pajorge/repository/gleitschiene-links/referencia/foto_anotada.jpg

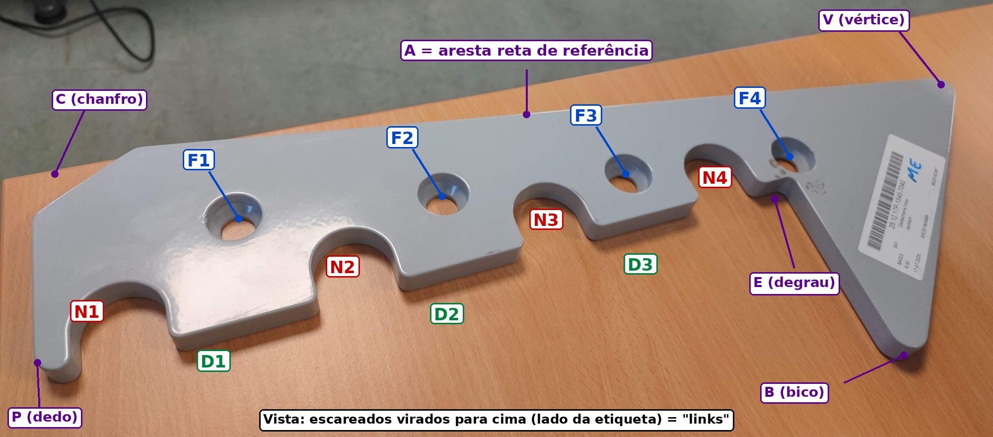
gleitschiene-links/referencia/foto_anotada.jpg
