pajorge/repository/gleitschiene-links/medicao/esquema_medicao.pdf

F1 | F2 | F3 | F4

N1

N2

N3

N4

## aresta A (reta)

F1 no 100

COMO
1. Fita presa ao longo da aresta A com o centro do F1 no 100 (como antes).
2. ANTES: encosta o esquadro à aresta A e escreve a leitura da régua do esquadro na própria aresta A → RA = ____
3. Para cada ponto P: base do esquadro na aresta A; desliza até a régua do esquadro passar EXATAMENTE no ponto. Escreve 2 leituras: X na fita e R na régua do esquadro. (Y = distância entre R e RA — faço eu as contas.)
4. Cada parede tem 2 pontos: 'em cima' (logo abaixo do arco) e 'em baixo' (4 mm acima do canto do dente).
A régua do esquadro só toca a parede no ponto — é normal, é assim que se mede o ângulo.
5. Quadrados laranja (X1–X5): só a leitura da fita.

Parede inclinada ou arredondamento?

folga SÓ numa ponta
= parede inclinada

folga nas DUAS pontas
= arredondamentos (normal)
0 | 50 | 100 | 150 | 200 | 250 | 300 | 350 | 400 | 450 | 500 | 550

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
X2 X3

X4

X5

# 1) PONTOS: X na fita + Y na régua do esquadro (2 pontos por parede)

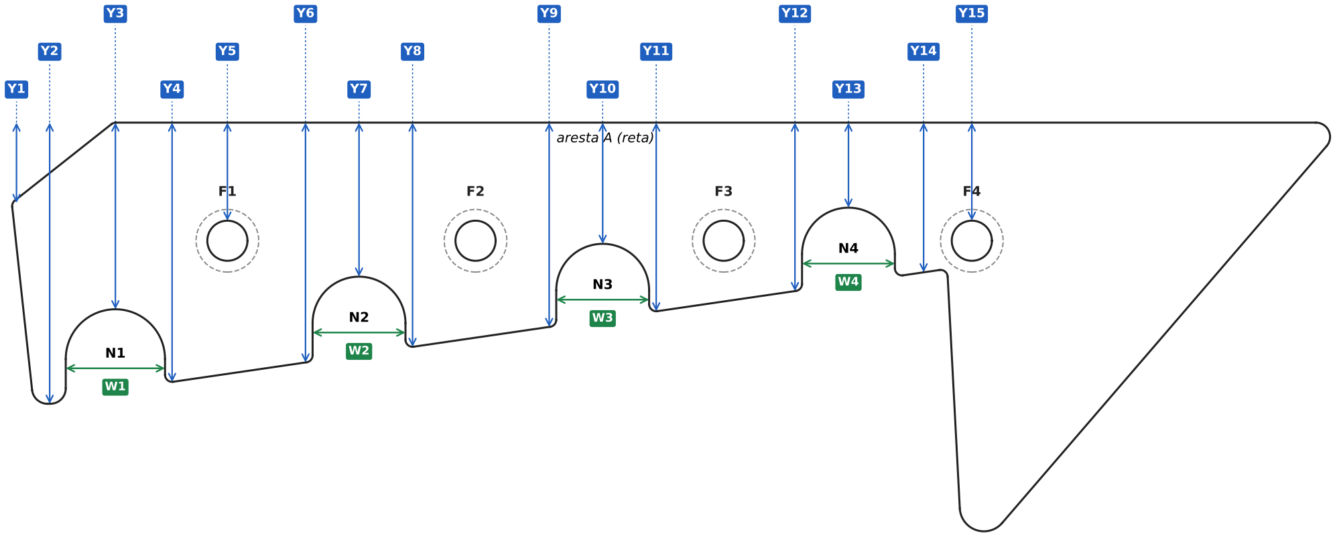
[picture p2: figure]
aresta A (reta)

COMO
- Y (azul): um bico do paquímetro na aresta A e o outro no ponto, sempre a 90° da aresta A.

Dentes: a ~3 mm do canto. Rasgos (Y3, Y7, Y10, Y13): o bico entra e encosta no fundo do arco. Furos (Y5, Y15): da aresta A ao bordo mais próximo, do lado SEM caixa.
- W (verde): largura de cada rasgo com os bicos de DENTRO, perto da boca, a 90° das paredes.
- Escreve só o que leres (com tinta). A correção da tinta faço eu.

# 2) ALTURAS e LARGURAS com o paquímetro

# 3) TABELA — pontos (fita + esquadro)

Esperado = modelo atual, com as paredes ainda a 90°. Nas paredes, diferenças de alguns mm no X são o que queremos medir.

# | O quê | X esp. | Y esp. | X lido (fita) | R lido (esquadro)

| RA = leitura da régua do esquadro na aresta A
| PONTOS NAS PAREDES
P1 | topo esquerda, em cima (3 mm abaixo do chanfro) | 9 | 37
P2 | topo esquerda, em baixo (10 mm acima do fundo do dedo) | 17 | 109
P3 | N1 parede esquerda, em cima (logo abaixo do arco) | 32 | 102
P4 | N1 parede esquerda, em baixo (4 mm acima do canto) | 32 | 112
P5 | N1 parede direita, em cima (logo abaixo do arco) | 74 | 102
P6 | N1 parede direita, em baixo (4 mm acima do canto) | 74 | 106
P7 | N2 parede esquerda, em cima (logo abaixo do arco) | 136 | 87
P8 | N2 parede esquerda, em baixo (4 mm acima do canto) | 136 | 97
P9 | N2 parede direita, em cima (logo abaixo do arco) | 175 | 87
P10 | N2 parede direita, em baixo (4 mm acima do canto) | 175 | 91
P11 | N3 parede esquerda, em cima (logo abaixo do arco) | 239 | 73
P12 | N3 parede esquerda, em baixo (4 mm acima do canto) | 239 | 82
P13 | N3 parede direita, em cima (logo abaixo do arco) | 278 | 73
P14 | N3 parede direita, em baixo (4 mm acima do canto) | 278 | 76
P15 | N4 parede esquerda, em cima (logo abaixo do arco) | 343 | 58
P16 | N4 parede esquerda, em baixo (4 mm acima do canto) | 343 | 67
P17 | N4 parede direita, em cima (logo abaixo do arco) | 382 | 58
P18 | N4 parede direita, em baixo (4 mm acima do canto) | 382 | 61
P19 | degrau E, em cima (5 mm abaixo do patamar) | 405 | 67
P20 | degrau E, em baixo (logo acima do arredondamento do bico) | 410 | 160
| SÓ FITA
X1 | fim do chanfro na aresta A | 52
X2 | F1 bordo esquerdo | 92
X3 | F1 bordo direito | 108
X4 | bico B (ponto mais baixo) | 420
X5 | fim da peça (vértice V) | 567

# 4) TABELA — paquímetro, raios e outros

Esperado = modelo atual, já com a tinta (Y +1 mm; larguras −1 mm). Diferença > 2 mm → mede de novo.

# | O quê | Esperado | Lido

| ALTURAS (paquímetro, com tinta)
Y1 | chanfro: quanto desce na topo | 35
Y2 | altura total no dedo P | 120
Y3 | N1: da aresta A ao fundo do rasgo | 80
Y4 | D1 canto esquerdo (a 3 mm) | 111
Y5 | F1: da aresta A ao bordo do furo | 42
Y6 | D1 canto direito (a 3 mm) | 103
Y7 | N2: da aresta A ao fundo do rasgo | 66
Y8 | D2 canto esquerdo (a 3 mm) | 96
Y9 | D2 canto direito (a 3 mm) | 87
Y10 | N3: da aresta A ao fundo do rasgo | 52
Y11 | D3 canto esquerdo (a 3 mm) | 81
Y12 | D3 canto direito (a 3 mm) | 72
Y13 | N4: da aresta A ao fundo do rasgo | 37
Y14 | patamar antes do degrau E | 64
Y15 | F4: da aresta A ao bordo do furo | 42
| LARGURAS DOS RASGOS (bicos de dentro, com tinta)
W1 | N1: largura (bicos de dentro do paquímetro) | 41.0
W2 | N2: largura (bicos de dentro do paquímetro) | 38.3
W3 | N3: largura (bicos de dentro do paquímetro) | 38.3
W4 | N4: largura (bicos de dentro do paquímetro) | 38.3
| RAIOS (moeda que encaixa no canto)
R1 | vértice V | R6
R2 | bico B | R10
R3 | cantos de fora dos dentes / patamar | R3
R4 | cantos de dentro (degrau E, patamar) | R3
R5 | cantos do chanfro C | R3
R6 | ponta do dedo P | R6.5
| OUTROS
L | comprimento total (de ponta a ponta) | 559
Q2 | parafuso: rosca / Ø cabeça / altura / norma | M16 / ≤26 / ? / ?
Q3 | a cabeça entra toda na caixa Ø26.5? | sim
Q4 | lima: escorrega (Hardox) ou morde (S355)? | ?
Q5 | peso na balança | ≈5.4 kg
