pajorge/repository/gleitschiene-links/cad/desenho_gleitschiene_links.png

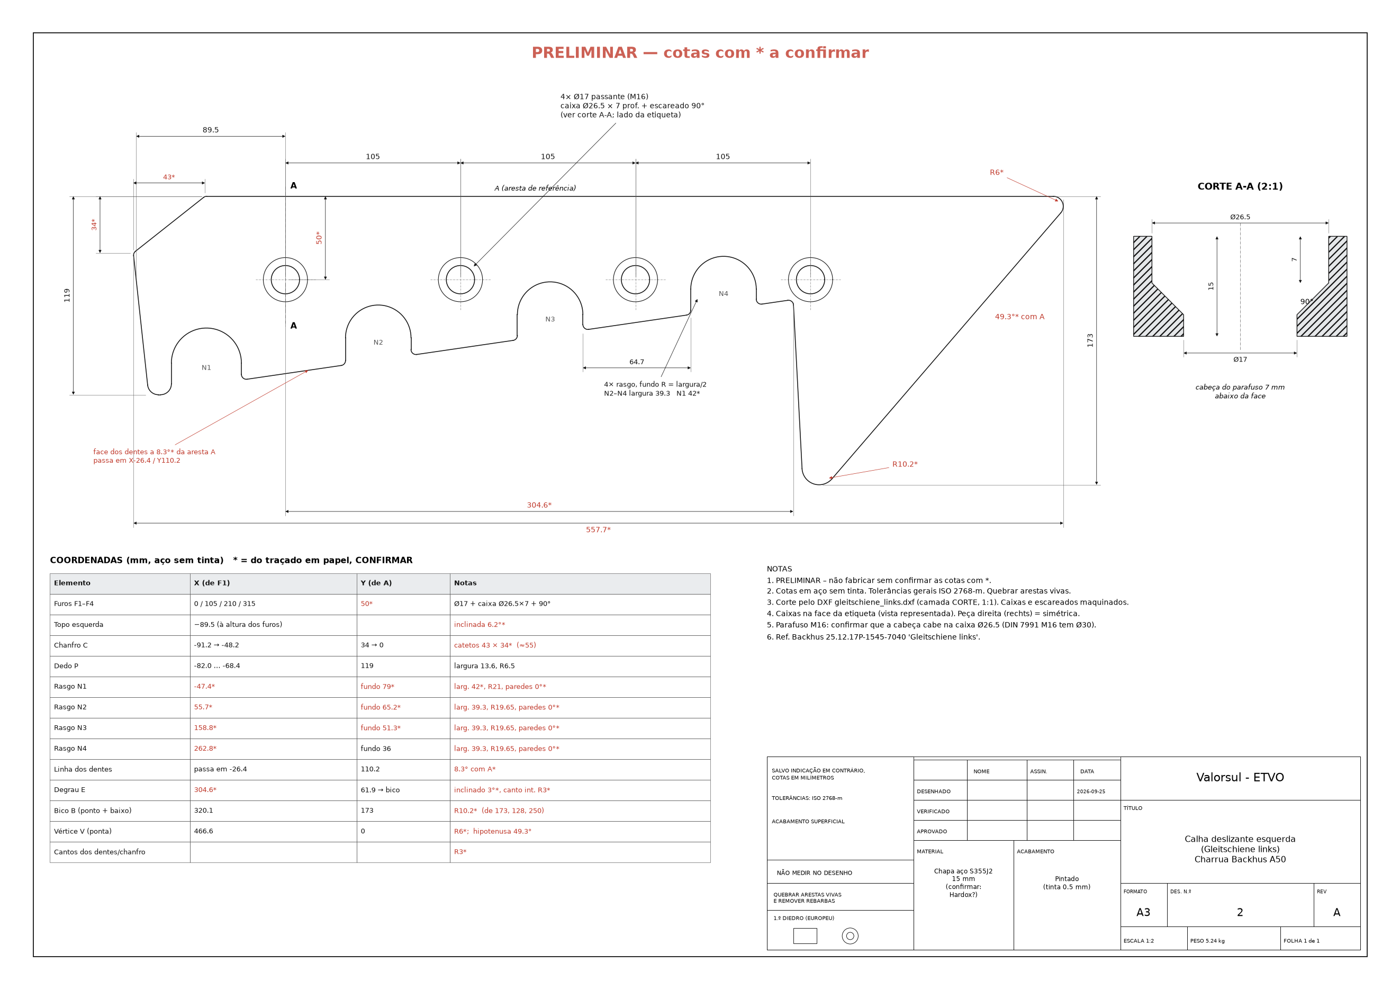
gleitschiene-links/cad/desenho_gleitschiene_links.png
