pajorge/repository/gleitschiene-links/cad/preview_3d.png

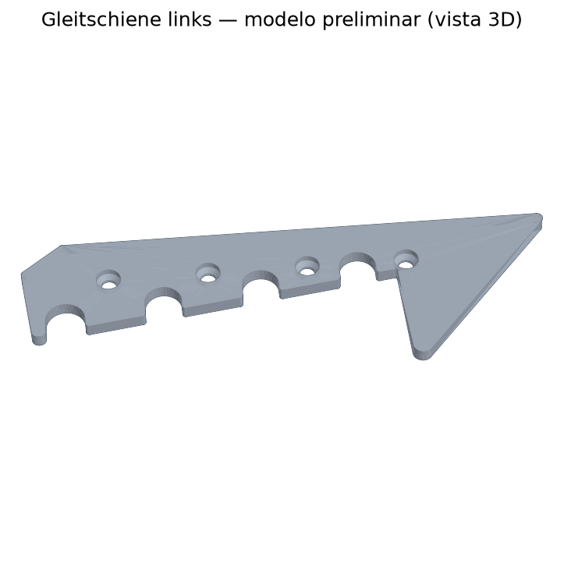
gleitschiene-links/cad/preview_3d.png
