pajorge/repository/gleitschiene-links/medicao/pagina1_pontos.png

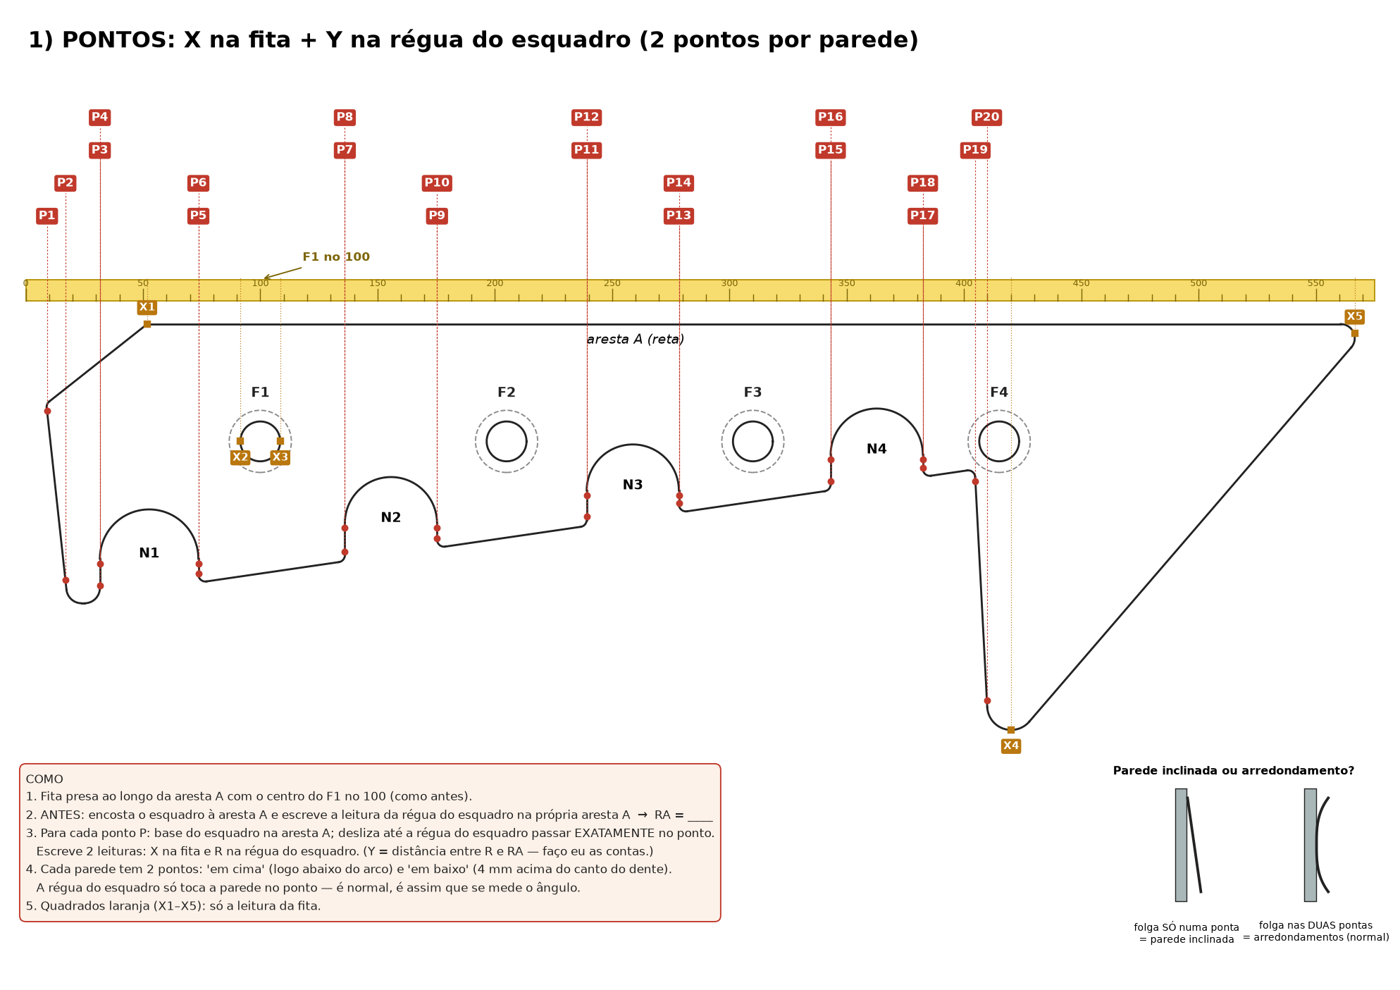
gleitschiene-links/medicao/pagina1_pontos.png
