pajorge/repository/gleitschiene-links/medicao/pagina2_alturas_larguras.png

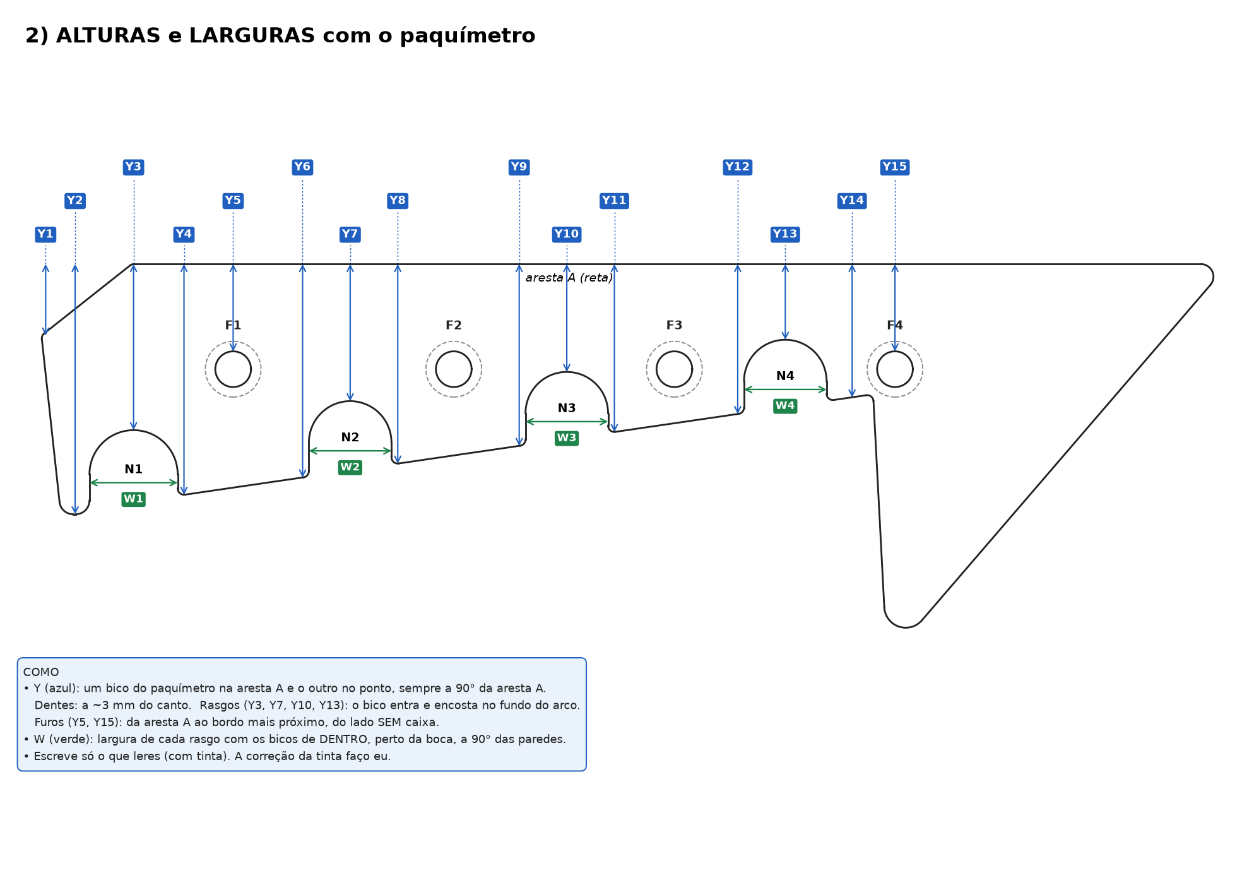
gleitschiene-links/medicao/pagina2_alturas_larguras.png
