pajorge/repository/gleitschiene-links/medicao/pagina3_tabela_pontos.png

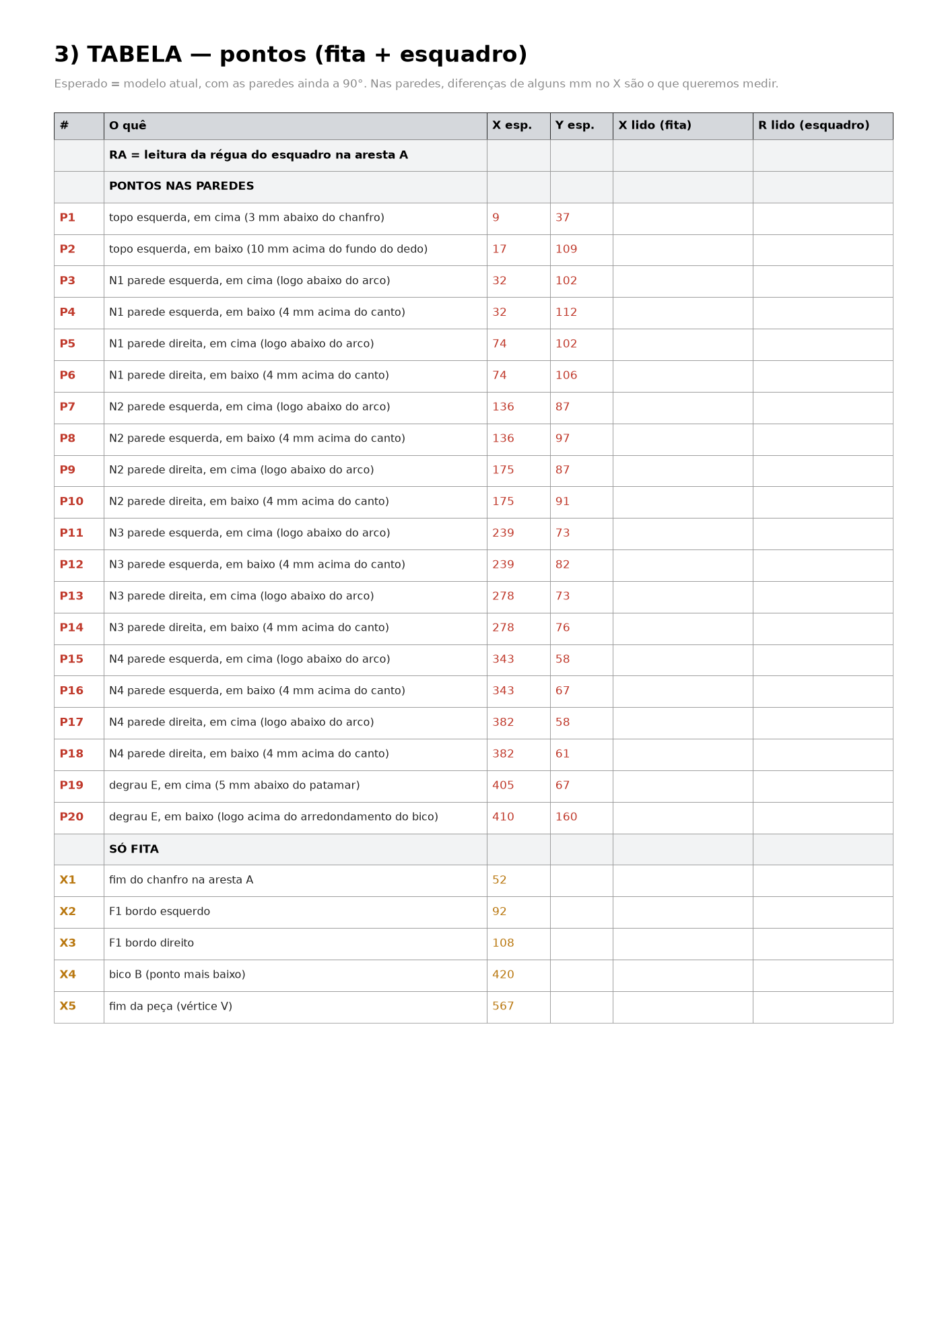
gleitschiene-links/medicao/pagina3_tabela_pontos.png
