pajorge/repository/gleitschiene-links/medicao/pagina4_tabela_paquimetro.png

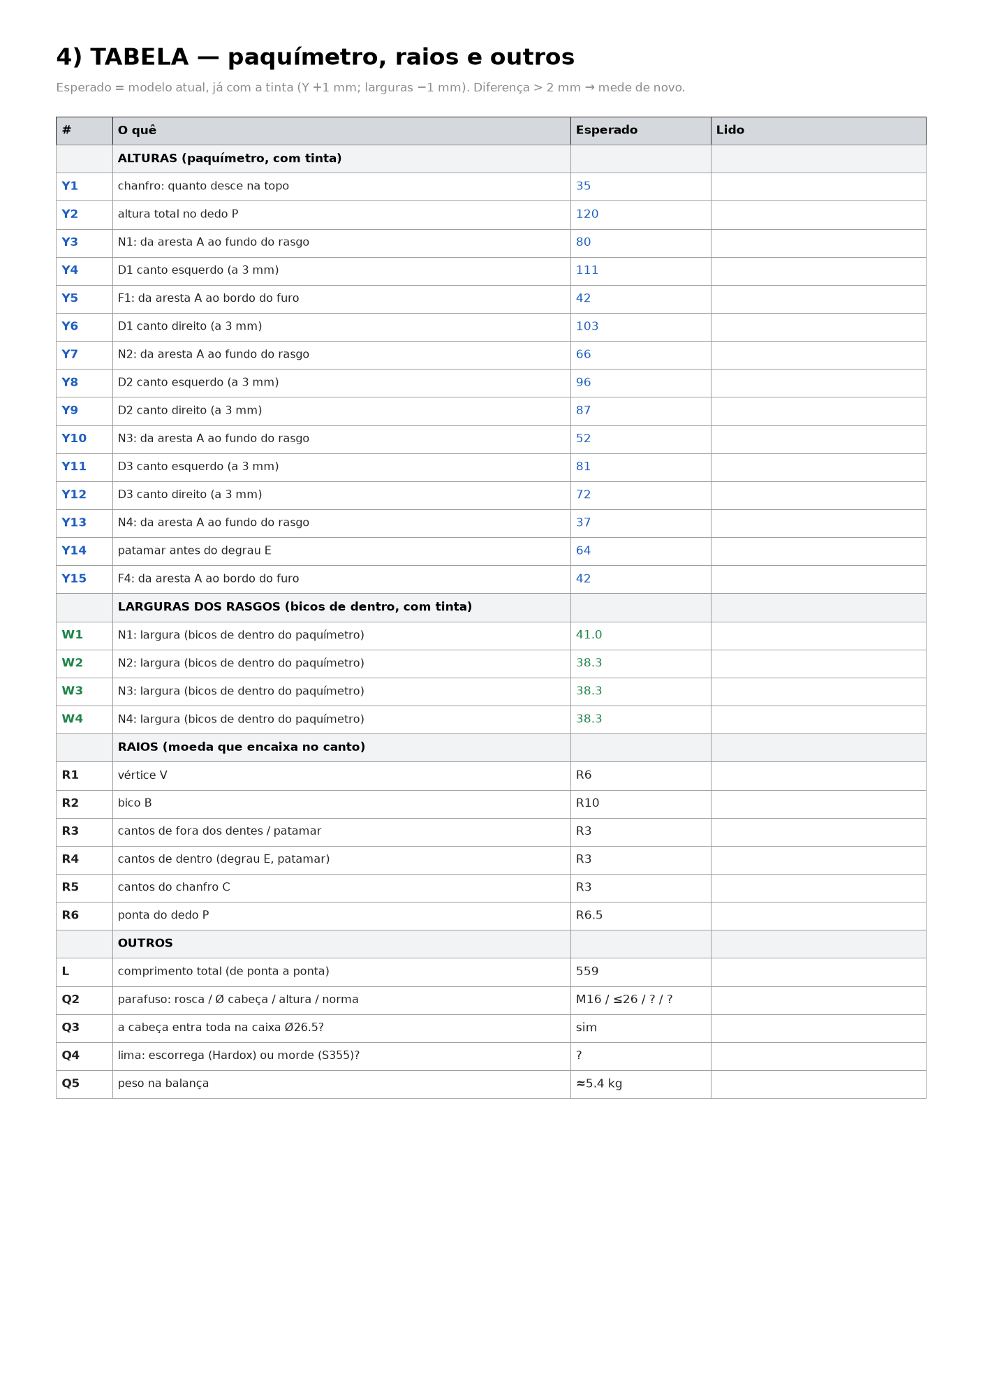
gleitschiene-links/medicao/pagina4_tabela_paquimetro.png
