pajorge/repository/gleitschiene-links/cad/gleitschiene_links.step

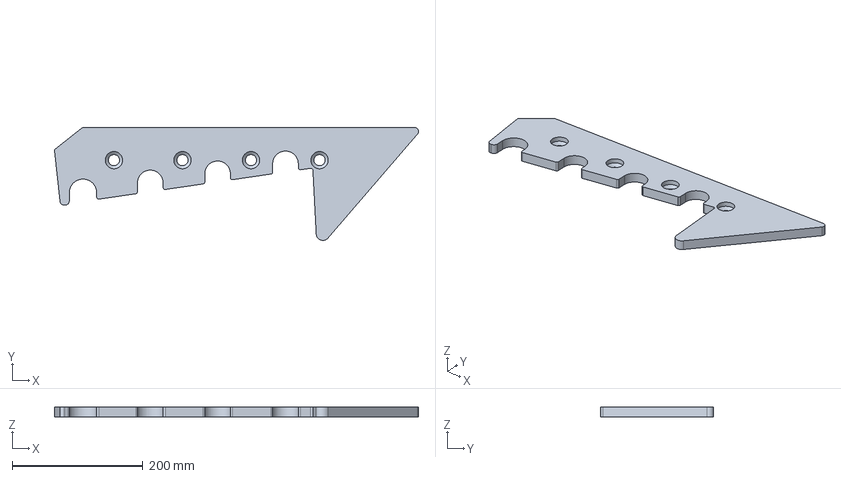
[picture p9: CAD file, 2026-09-25]
gleitschiene-links/cad/gleitschiene_links.step
557.7 x 173.0 x 15.0 mm
