pajorge/repository/(list of files, cad)

Other CAD files:
gleitschiene-links/cad/gleitschiene_links.dxf
