pajorge/repository/gleitschiene-links/cad/desenho_gleitschiene_links.pdf

## CORTE A-A (2:1)

# PRELIMINAR — cotas com * a confirmar

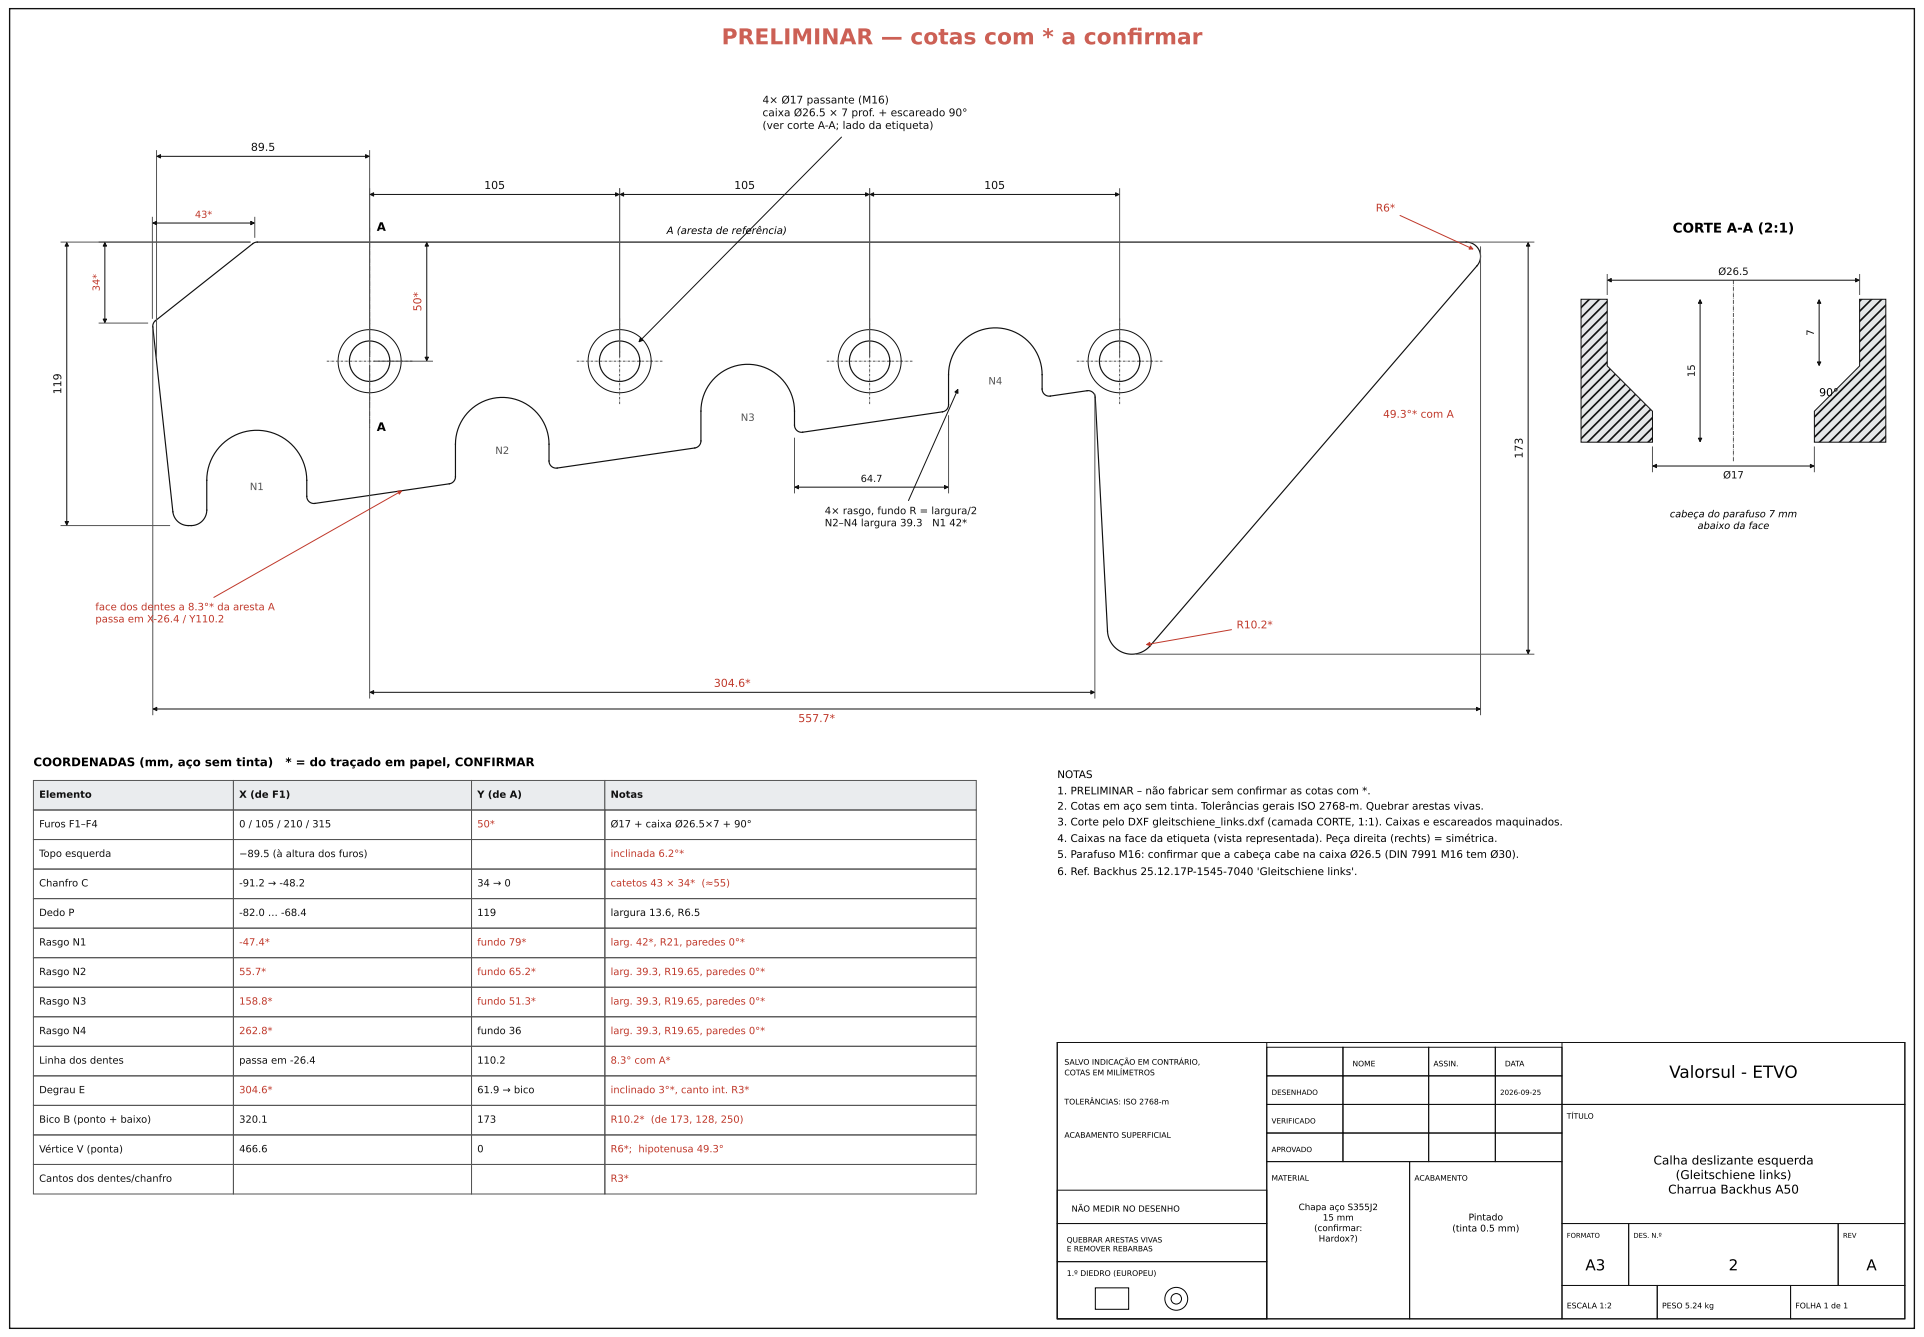
[picture p10: page 1]
49.3°* com A; Elemento; Notas; Furos F1–F4; Ø17 + caixa Ø26.5×7 + 90°; Topo esquerda; −89.5 (à altura dos furos); inclinada 6.2°*; Chanfro C; catetos 43 × 34* (≈55); Dedo P; largura 13.6, R6.5; Rasgo N1; fundo 79*; larg. 42*, R21, paredes 0°*; Rasgo N2; fundo 65.2*; larg. 39.3, R19.65, paredes 0°*; Rasgo N3; fundo 51.3*; Rasgo N4; fundo 36; Linha dos dentes; passa em -26.4; 8.3° com A*; Degrau E; 61.9 → bico; inclinado 3°*, canto int. R3*; Bico B (ponto + baixo); Vértice V (ponta); R6*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

4× Ø17 passante (M16)
caixa Ø26.5 × 7 prof. + escareado 90°
(ver corte A-A; lado da etiqueta)

A A (aresta de referência)

4× rasgo, fundo R = largura/2
N2–N4 largura 39.3 N1 42*

cabeça do parafuso 7 mm
abaixo da face

face dos dentes a 8.3°* da aresta A
passa em X-26.4 / Y110.2

COORDENADAS (mm, aço sem tinta) * = do traçado em papel, CONFIRMAR

NOTAS
1. PRELIMINAR – não fabricar sem confirmar as cotas com *.

2. Cotas em aço sem tinta. Tolerâncias gerais ISO 2768-m. Quebrar arestas vivas.
3. Corte pelo DXF gleitschiene_links.dxf (camada CORTE, 1:1). Caixas e escareados maquinados.
4. Caixas na face da etiqueta (vista representada). Peça direita (rechts) = simétrica.
5. Parafuso M16: confirmar que a cabeça cabe na caixa Ø26.5 (DIN 7991 M16 tem Ø30).

6. Ref. Backhus 25.12.17P-1545-7040 'Gleitschiene links'.

SALVO INDICAÇÃO EM CONTRÁRIO,
COTAS EM MILÍMETROS

Calha deslizante esquerda
(Gleitschiene links)
Charrua Backhus A50

NÃO MEDIR NO DESENHO

QUEBRAR ARESTAS VIVAS
E REMOVER REBARBAS
