pajorge/repository/gleitschiene-links/VERIFICACAO.md

# Gleitschiene links (calha deslizante esquerda), Backhus A50

Referência na etiqueta: **25.12.17P-1545-7040**, "Gleitschiene links", "-lackiert-".

Nomes dos elementos: ver `referencia/foto_anotada.jpg`.
Convenção: vista com os escareados virados para nós, aresta reta **A** em cima, triângulo à direita.

## Incongruências encontradas nos esboços

O papel está à escala 1:1. Confirmei-o no desenho: o dente de 64.7, o degrau de 102, a altura de 173 e o furo Ø16 dão todos a mesma escala (~5.1 px/mm na foto 3). Assim dá para comparar as cotas escritas com o traço.

1. **Correção da tinta com o sinal trocado nas medidas interiores.** A tinta aumenta as medidas exteriores (aço = medido − 1 mm) mas **diminui** as interiores (furos, largura de rasgos, escareados: aço = medido **+** 1 mm). No esboço estão todas com +1: Ø16 (17), escareado 25.5 (26.6), rasgo 38.3 (39.3), 34.7 (35.2).
2. **"34.7" no rasgo N4 lê-se como raio, mas não é.** Pelo traço, o N4 tem ~39 mm de largura e ~32–35 mm de profundidade, o que dá um raio de fundo de ~19.5. Portanto 38.3 é a largura e 34.7 é a profundidade. Um fornecedor que lesse R34.7 faria um rasgo com 69 mm.
3. **O escareado não fecha.** De Ø25.5 para Ø16 com 7 mm de fundo dá um ângulo de ~68°, que não é normalizado. A 90° a profundidade seria 4.75 mm. Com 7 mm de fundo a 90°, o Ø em cima seria ~30 mm, que é a cabeça de um M16 DIN 7991 / ISO 10642. Especificar pelo parafuso.
4. **Falta a posição dos furos F1–F4**, que é a cota mais crítica porque tem de bater com a charrua. Pelo traço estão alinhados e paralelos à aresta A (confirmar).
5. **N1, N2, N3, D1 e D2 não têm cotas.** O N3 parece igual ao N4, mas o N1 (junto ao dedo P) parece diferente.
6. **A face dos dentes é inclinada** em relação à aresta A (~8°). A peça estreita de ~110–120 mm junto a P para ~65 mm junto a E, mas não há cotas suficientes para definir essa linha.
7. **110.2 (111.2) e (120) "?"**: não está claro de onde a onde medem. Pelo traço, a altura total no dedo P é ~112–118.
8. **Triângulo:** 208 (209) contra (250) só é coerente com raios de ~R8–R10 em V e B. Faltam esses raios e a posição do bico B ao longo do comprimento (ou o ângulo da hipotenusa).
9. **(567), (391) e (128)** só existem com tinta e sem referência clara. Não consegui perceber o que mede o (128).
10. **Chanfro C:** só tem o comprimento 55. Pelo traço tem ~34 (altura) × ~43.5 (comprimento), ≈38°.
11. **Espessura 14.7:** a chapa comercial é de 15 mm. 0.5 mm de tinta por face é muito; o normal é 0.1–0.2.
12. **Nenhum raio de canto está cotado:** cantos dos dentes, cantos interiores, V, B e a ponta de P.
13. **Mão:** é a peça "links". A direita é a mesma espelhada, com os escareados na outra face.

## Medições a fazer (preencher)

Usar paquímetro e esquadro apoiado na aresta A. Nos furos, medir no lado **sem** escareado.

| # | Medida | Valor (aço) |
|---|---|---|
| 1 | Espessura (raspar 1 ponto escondido) | |
| 2 | Ø furo F1 / F2 / F3 / F4 | |
| 3 | Entre centros F1–F2, F2–F3, F3–F4 | |
| 4 | Centro de cada furo → aresta A (F1…F4) | |
| 5 | Centro de F1 → ponta esquerda (canto do chanfro) | |
| 6 | Escareado: Ø em cima, profundidade, ângulo (ou parafuso: rosca, Ø cabeça, altura, norma) | |
| 7 | Rasgos N1…N4: largura, profundidade, posição (eixo do rasgo → F mais próximo) | |
| 8 | Dentes D1…D3 e patamar antes de E: comprimento | |
| 9 | Altura (aresta A → face) nos 2 cantos de D1, D2, D3, no dedo P e no patamar de E | |
| 10 | Paredes dos rasgos: perpendiculares à aresta A? (sim/não) | |
| 11 | Chanfro C: recuo na aresta A e descida na topo | |
| 12 | Dedo P: largura e raio da ponta | |
| 13 | Degrau E: comprimento; bico B: distância à aresta A (173?) e ao vértice V ao longo de A | |
| 14 | Raios: V, B, cantos exteriores dos dentes, cantos interiores | |
| 15 | Comprimento total ao longo de A | |
| 16 | Material: teste da lima (escorrega = anti-desgaste tipo Hardox; morde = S235/S355) | |
| 17 | Peso da peça (confirma área e espessura contra o CAD) | |

## Dicas

- Guardar o papel traçado. Está a 1:1 e continua a servir depois de a peça ir para a máquina.
- Tirar uma foto "de satélite": peça pousada no chão sobre fundo liso, telemóvel paralelo e afastado (~1.5 m, com zoom), fita métrica encostada à peça e as 4 esquinas de uma folha A4 visíveis. Com isso corrijo a perspetiva e confirmo o contorno.
- Guardar a peça velha que sai da charrua, porque as posições dos furos são as mesmas.

## Medidas recebidas (2.ª folha)

- Centros dos furos a partir do F1: 105 / 210 / 315 (passo 105).
- F1 → topo esquerda: (90).
- (120) = altura total na ponta esquerda, da aresta A ao dedo P.
- (128) e (250) são medidas até aos cantos vivos teóricos do triângulo (coerente com R~9–10 em V e B).

Guia de medição detalhado (X ao longo de A, Y a partir de A, escareado e raios): `medicao/esquema_medicao.pdf`.

## Escareado (3.ª folha)

Caixa cilíndrica Ø25.5 com 7 de fundo, depois cone, depois furo Ø16 com 3 de altura no fundo.
Para o cone sobram 14.7 − 7 − 3 = 4.7 mm; de Ø25.5 para Ø16 em 4.7 mm dá ~90°. Bate certo.
Falta confirmar: o que o paquímetro leu nos furos pintados (Ø aço = Ø lido + 1) e o parafuso.

## Tinta e parafuso

- Tinta medida com medidor: 0.5 mm por face. Exteriores: aço = lido − 1. Furos e caixas: aço = lido + 1.
- Espessura em aço 14.7 → especificar chapa de 15 mm.
- Parafuso M16 (porcas M16). Leitura 16 no furo pintado → aço Ø17, a passagem normal para M16.
  Caixa lida 25.5 → aço Ø26.5; o cone de Ø26.5 a Ø17 em ~4.7 mm continua a dar 90°.
- ATENÇÃO: um M16 de cabeça de embeber normal (DIN 7991 / ISO 10642) tem cabeça Ø30 e não cabe
  numa caixa de Ø26.5. Medir a cabeça dos parafusos originais antes de fechar o desenho.
