pajorge/repository/(commit log)

2026-09-24 Gleitschiene links (Backhus A50): lista de verificação e foto anotada
    Incongruências encontradas nos esboços e medições a tirar antes de a
    peça ser montada, com foto de referência com os elementos nomeados.
    Claude-Session: https://claude.ai/code/session_016z6yiPFVEC1wPm1DjLq5ht
2026-09-24 Gleitschiene links: esquema de medição (posições, alturas, escareado, raios)
    Guia em PDF/PNG gerado a partir do traçado 1:1, com valores aproximados
    para confirmar na peça e as incongruências que ainda faltam resolver.
    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
2026-09-24 Gleitschiene links: tinta 0,5 mm confirmada e parafuso M16
    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
2026-09-24 Gleitschiene links: modelo CAD preliminar (STEP, DXF, desenho A3)
    Modelo paramétrico em build123d gerado a partir das medidas e do traçado
    1:1: contorno com rasgos e raios, 4 furos M16 com caixa Ø26.5x7 e cone a
    90°. Desenho A3 1:2 com tabela de coordenadas e cotas a confirmar marcadas.
    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
    [gleitschiene_links.dxf, gleitschiene_links.step]
2026-09-24 Gleitschiene links: folha de medição gerada a partir do modelo CAD
    Valores esperados saem de cad/gleitschiene.py; fita com o centro do F1 no
    100, alturas com +1 mm de tinta, e tabela para preencher na peça.
    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
2026-09-25 Gleitschiene links: paredes e degrau inclinados no modelo; medição por pontos
    Com o esquadro viu-se que as paredes dos rasgos e o degrau E não estão a
    90° da aresta A. O modelo passa a ter um ângulo por rasgo e para o degrau
    (provisório 3°, do traçado). A folha de medição passa a medir 2 pontos
    (X na fita + Y no esquadro) por parede, para tirar os ângulos.
    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
    [gleitschiene_links.dxf, gleitschiene_links.step]
